trm84/SDP-BMS-CIRCUIT/12S.brd

## EAGLE design 12S.brd (2019-02-24)

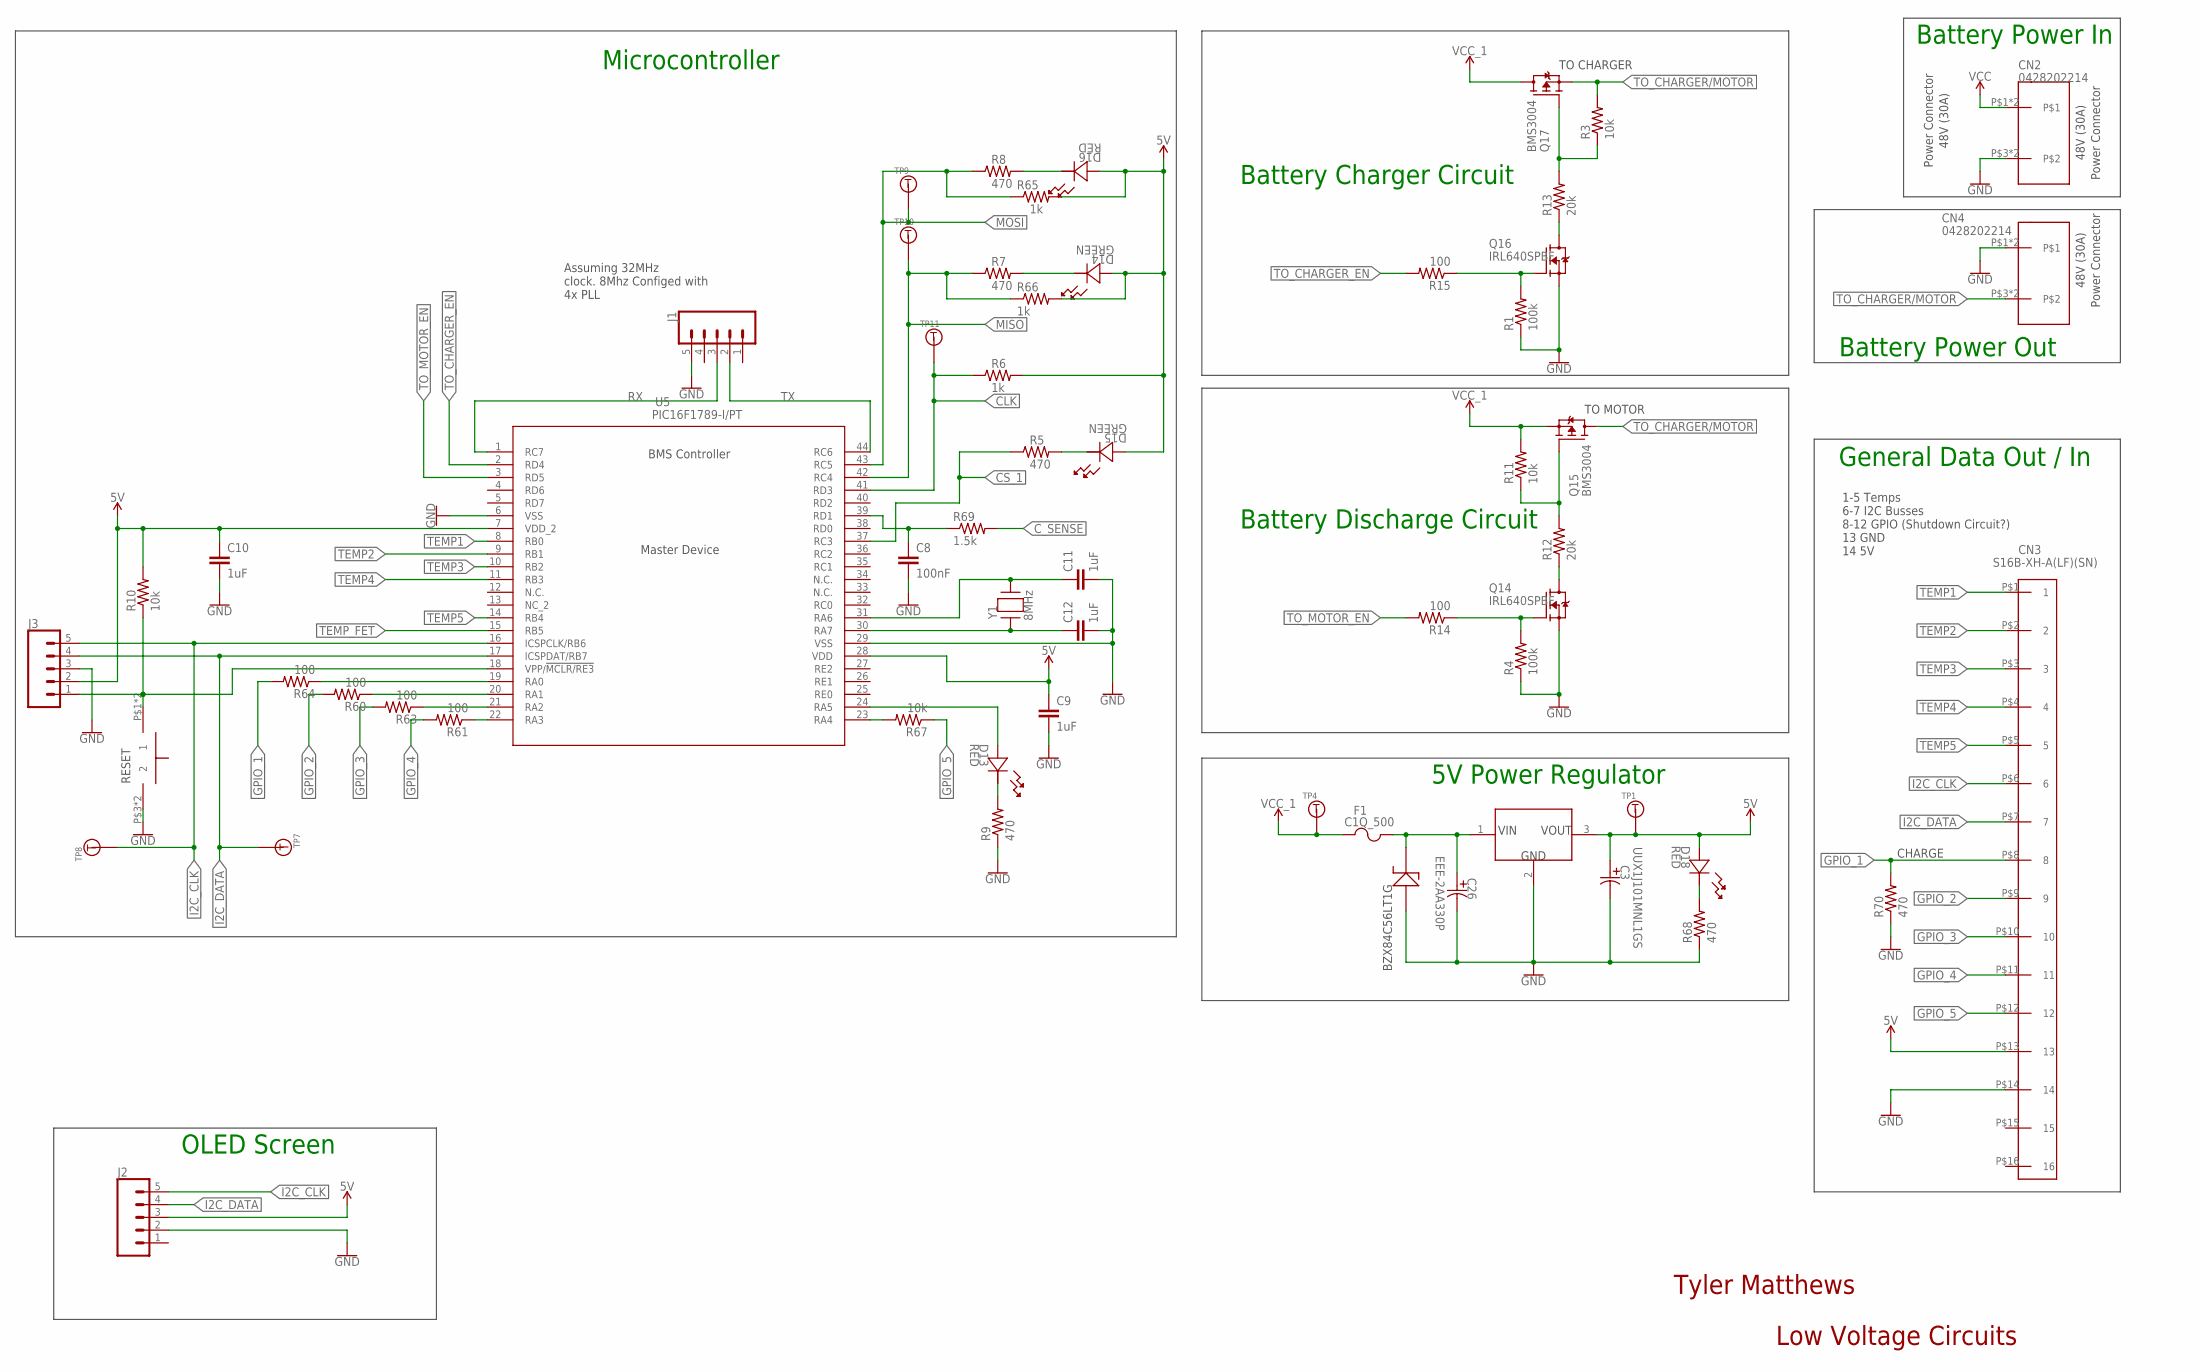
[picture p1: schematic 12S.sch, sheet 1]

Parts:
C3: UUX1J101MNL1GS; PCAP_10X10-ELECT
C8: 100nF; C0603
C9, C10, C11, C12: 1uF; C0603
C26: EEE-2AA330P; CAP_EEE_G
CN2, CN4: 0428202214
CN3: S16B-XH-A(LF)(SN)
D13, D16, D18: RED; LED_DIALIGHT_598
D14, D15: GREEN; LED_DIALIGHT_598
D17: BZX84C56LT1G; SOT-23
F1: C1Q_500; C1
J1, J2, J3: CONN_05; 1X05
Q14, Q16: IRL640SPBF; D2PAK
Q15, Q17: BMS3004; TO-220
R1, R4: 100k; R0603
R3, R10, R11, R67: 10k; R0603
R5, R7, R8, R9, R68, R70: 470; R0603
R6, R65, R66: 1k; R0603
R12, R13: 20k; R0603
R14, R15, R60, R61, R63, R64: 100; R0603
R69: 1.5k; R0603
S2: TL3305AF260QG
TP1, TP4, TP7, TP8, TP9, TP10, TP11: TP5015
U3: SRH05S05; SIP3
U5: PIC16F1789-I/PT; TQFP44_MC
Y1: 8MHz; CRYSTAL_HC49SDLF

Connections:
5V: C3.1 (11), C9.1, C10.1, CN3.P$13 (13), D14.2 (22), D15.2 (22), D16.2 (22), D18.2 (22), J2.3, J3.2, R6.2, R10.2, R65.2, R66.2, TP1.P$1, U3.3 (VOUT), U5.7 (VDD_2), U5.28 (VDD); also elsewhere on the board
CLK: R6.1, TP11.P$1, U5.41 (RD3); also elsewhere on the board
CS_1: R5.1, U5.37 (RC3); also elsewhere on the board
C_SENSE: R69.2; also elsewhere on the board
GND: C3.2 (22), C8.2, C9.2, C10.2, C11.2, C12.2, C26.2 (22), CN2.P$3, CN2.P$4, CN3.P$14 (14), CN4.P$1, CN4.P$2, D17.1, J1.5, J2.2, J3.3, Q14.2 (S), Q16.2 (S), R1.1, R4.1, R9.1, R68.1, R70.1, S2.P$3 (2), S2.P$4 (2), U3.2 (GND), U5.6 (VSS), U5.29 (VSS); also elsewhere on the board
GPIO_1: CN3.P$8 (8), R64.2, R70.2
GPIO_2: CN3.P$9 (9), R60.2
GPIO_3: CN3.P$10 (10), R63.2
GPIO_4: CN3.P$11 (11), R61.2
GPIO_5: CN3.P$12 (12), R67.1
I2C_CLK: CN3.P$6 (6), J2.5, J3.5, TP8.P$1, U5.16 (ICSPCLK/RB6)
I2C_DATA: CN3.P$7 (7), J2.4, J3.4, TP7.P$1, U5.17 (ICSPDAT/RB7)
MISO: R7.1, R66.1, TP10.P$1, U5.42 (RC4); also elsewhere on the board
MOSI: R8.1, R65.1, TP9.P$1, U5.43 (RC5); also elsewhere on the board
unnamed: D16.1 (11), R8.2
unnamed: D14.1 (11), R7.2
unnamed: D15.1 (11), R5.2
unnamed: Q17.1 (G), R3.1, R13.2
unnamed: R61.1, U5.22 (RA3)
unnamed: R63.1, U5.21 (RA2)
unnamed: R60.1, U5.20 (RA1)
unnamed: R64.1, U5.19 (RA0)
unnamed: D18.1 (11), R68.2
unnamed: R67.2, U5.23 (RA4)
unnamed: C8.1, R69.1, U5.39 (RD1)
unnamed: C26.1 (11), D17.3, F1.2, U3.1 (VIN)
unnamed: Q14.3 (D), R12.1
unnamed: C11.1, U5.31 (RA6), Y1.2
unnamed: C12.1, U5.30 (RA7), Y1.1
unnamed: Q15.1 (G), R11.1, R12.2
unnamed: Q14.1 (G), R4.2, R14.1
unnamed: Q16.3 (D), R13.1
unnamed: Q16.1 (G), R1.2, R15.1
unnamed: J3.1, R10.1, S2.P$1 (1), S2.P$2 (1), U5.18 (VPP/!MCLR/RE3)
unnamed: D13.2 (22), U5.24 (RA5)
unnamed: D13.1 (11), R9.2
RX: J1.3, U5.1 (RC7)
TEMP1: CN3.P$1 (1), U5.8 (RB0); also elsewhere on the board
TEMP2: CN3.P$2 (2), U5.9 (RB1); also elsewhere on the board
TEMP3: CN3.P$3 (3), U5.10 (RB2); also elsewhere on the board
TEMP4: CN3.P$4 (4), U5.11 (RB3); also elsewhere on the board
TEMP5: CN3.P$5 (5), U5.14 (RB4); also elsewhere on the board
TEMP_FET: U5.15 (RB5); also elsewhere on the board
TO_CHARGER/MOTOR: CN4.P$3, CN4.P$4, Q15.2 (D), Q17.3 (S), R3.2
TO_CHARGER_EN: R15.2, U5.2 (RD4)
TO_MOTOR_EN: R14.2, U5.3 (RD5)
TX: J1.2, U5.44 (RC6)
VCC: CN2.P$1, CN2.P$2; also elsewhere on the board
VCC_1: F1.1, Q15.3 (S), Q17.2 (D), R11.2, TP4.P$1; also elsewhere on the board

Notes on the sheet:
Master Device
BMS Controller
Assuming 32MHz clock. 8Mhz Configed with 4x PLL
Microcontroller
5V Power Regulator
Battery Discharge Circuit
Battery Charger Circuit
Power Connector
48V (30A)
Battery Power Out
General Data Out / In
1-5 Temps 6-7 I2C Busses 8-12 GPIO (Shutdown Circuit?) 13 GND 14 5V
Battery Power In
TO CHARGER
TO MOTOR
Tyler Matthews
Low Voltage Circuits
RESET
BZX84C56LT1G
CHARGE
OLED Screen

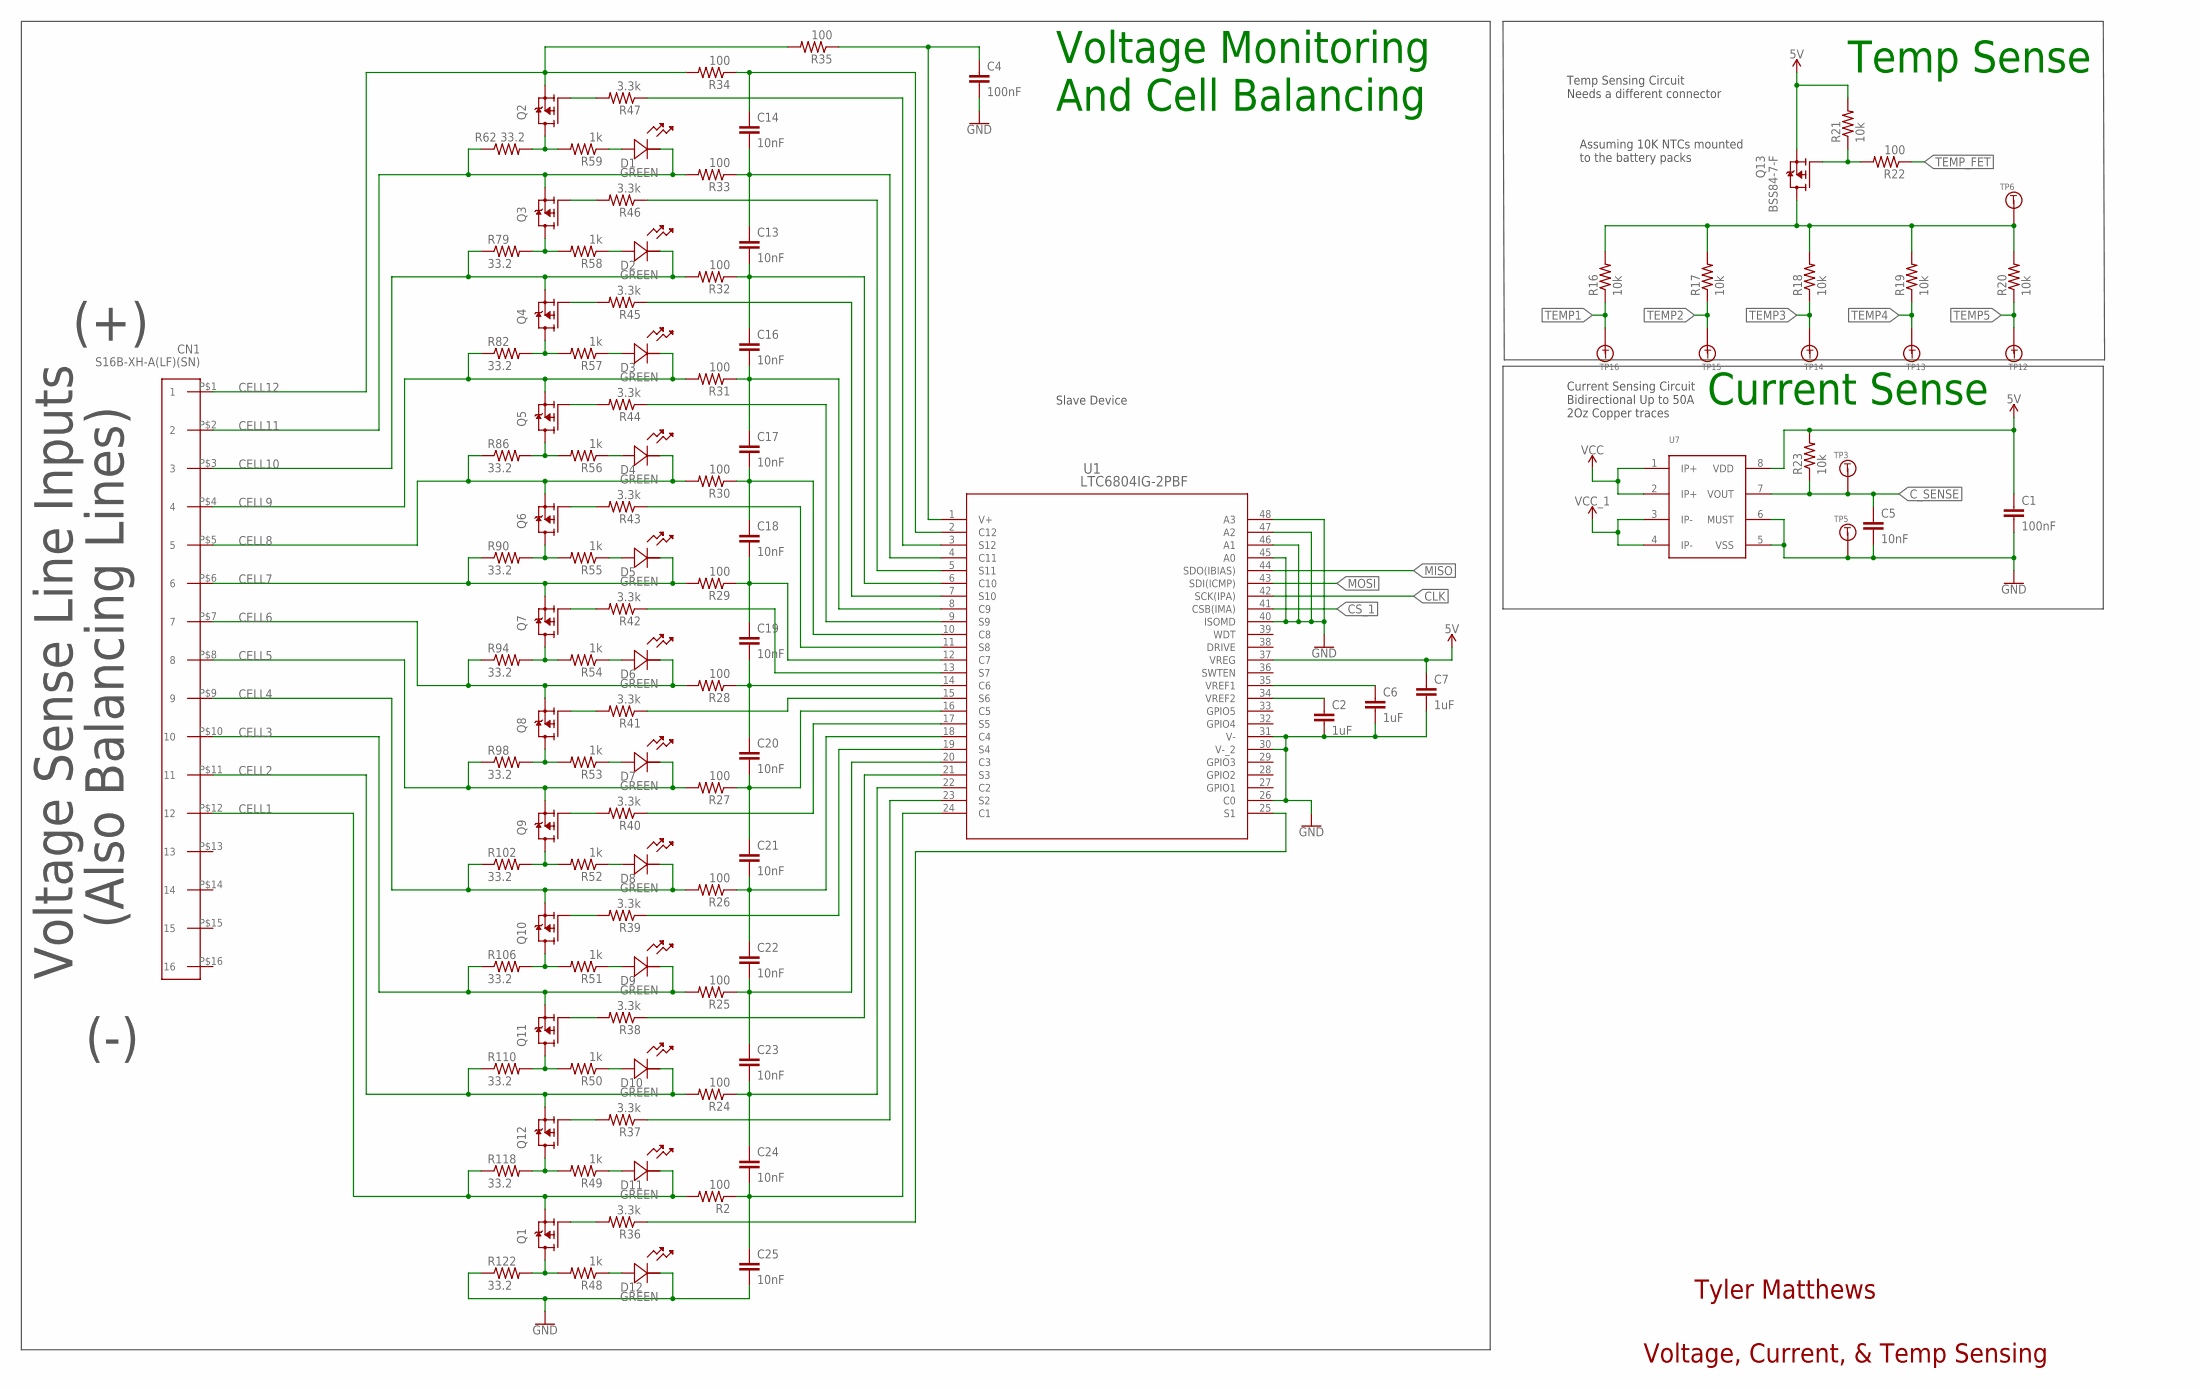
[picture p2: schematic 12S.sch, sheet 2]

Parts:
C1, C4: 100nF; C0603
C2, C6, C7: 1uF; C0603
C5, C13, C14, C16, C17, C18, C19, C20, C21, C22, C23, C24, C25: 10nF; C0603
CN1: S16B-XH-A(LF)(SN)
D1, D2, D3, D4, D5, D6, D7, D8, D9, D10, D11, D12: GREEN; LED_DIALIGHT_598
Q1, Q2, Q3, Q4, Q5, Q6, Q7, Q8, Q9, Q10, Q11, Q12: BSS308PEH6327XTSA1
Q13: BSS84-7-F; SOT-23
R2, R22, R24, R25, R26, R27, R28, R29, R30, R31, R32, R33, R34, R35: 100; R0603
R16, R17, R18, R19, R20, R21, R23: 10k; R0603
R36, R37, R38, R39, R40, R41, R42, R43, R44, R45, R46, R47: 3.3k; R0603
R48, R49, R50, R51, R52, R53, R54, R55, R56, R57, R58, R59: 1k; R0603
R62, R79, R82, R86, R90, R94, R98, R102, R106, R110, R118, R122: 33.2; R0805
TP3, TP5, TP6, TP12, TP13, TP14, TP15, TP16: TP5015
U1: LTC6804IG-2PBF; SSOP-48_G
U7: MLX91210; SOIC-8

Connections:
5V: C1.1, C7.1, Q13.2 (S), R21.2, R23.2, U1.37 (VREG), U7.8 (VDD); also elsewhere on the board
CELL1: CN1.P$12 (12), D11.1 (11), Q1.P$S (S), R2.2, R118.1
CELL2: CN1.P$11 (11), D10.1 (11), Q12.P$S (S), R24.2, R110.1
CELL3: CN1.P$10 (10), D9.1 (11), Q11.P$S (S), R25.2, R106.1
CELL4: CN1.P$9 (9), D8.1 (11), Q10.P$S (S), R26.2, R102.1
CELL5: CN1.P$8 (8), D7.1 (11), Q9.P$S (S), R27.2, R98.1
CELL6: CN1.P$7 (7), D6.1 (11), Q8.P$S (S), R28.2, R94.1
CELL7: CN1.P$6 (6), D5.1 (11), Q7.P$S (S), R29.2, R90.1
CELL8: CN1.P$5 (5), D4.1 (11), Q6.P$S (S), R30.2, R86.1
CELL9: CN1.P$4 (4), D3.1 (11), Q5.P$S (S), R31.2, R82.1
CELL10: CN1.P$3 (3), D2.1 (11), Q4.P$S (S), R32.2, R79.1
CELL11: CN1.P$2 (2), D1.1 (11), Q3.P$S (S), R33.2, R62.1
CELL12: CN1.P$1 (1), Q2.P$S (S), R34.2, R35.2
CLK: U1.42 (SCK(IPA)); also elsewhere on the board
CS_1: U1.41 (CSB(IMA)); also elsewhere on the board
C_SENSE: C5.1, R23.1, TP3.P$1, U7.7 (VOUT); also elsewhere on the board
GND: C1.2, C2.2, C4.2, C5.2, C6.2, C7.2, C25.2, D12.1 (11), R122.1, TP5.P$1, U1.26 (C0), U1.30 (V-_2), U1.31 (V-), U1.40 (ISOMD), U1.45 (A0), U1.46 (A1), U1.47 (A2), U1.48 (A3), U7.5 (VSS), U7.6 (MUST); also elsewhere on the board
MISO: U1.44 (SDO(IBIAS)); also elsewhere on the board
MOSI: U1.43 (SDI(ICMP)); also elsewhere on the board
unnamed: C6.1, U1.35 (VREF1)
unnamed: C2.1, U1.34 (VREF2)
unnamed: Q13.1 (G), R21.1, R22.2
unnamed: Q13.3 (D), R16.2, R17.2, R18.2, R19.2, R20.2, TP6.P$1
unnamed: Q2.P$G (G), R47.2
unnamed: R47.1, U1.3 (S12)
unnamed: C14.1, R34.1, U1.2 (C12)
unnamed: Q2.P$D (D), R59.2, R62.2
unnamed: D1.2 (22), R59.1
unnamed: C13.1, C14.2, R33.1, U1.4 (C11)
unnamed: R46.1, U1.5 (S11)
unnamed: Q3.P$G (G), R46.2
unnamed: Q3.P$D (D), R58.2, R79.2
unnamed: D2.2 (22), R58.1
unnamed: C13.2, C16.1, R32.1, U1.6 (C10)
unnamed: Q4.P$G (G), R45.2
unnamed: R45.1, U1.7 (S10)
unnamed: Q4.P$D (D), R57.2, R82.2
unnamed: D3.2 (22), R57.1
unnamed: Q5.P$G (G), R44.2
unnamed: C16.2, C17.1, R31.1, U1.8 (C9)
unnamed: R44.1, U1.9 (S9)
unnamed: Q5.P$D (D), R56.2, R86.2
unnamed: D4.2 (22), R56.1
unnamed: C17.2, C18.1, R30.1, U1.10 (C8)
unnamed: Q6.P$G (G), R43.2
unnamed: R43.1, U1.11 (S8)
unnamed: Q6.P$D (D), R55.2, R90.2
unnamed: D5.2 (22), R55.1
unnamed: C18.2, C19.1, R29.1, U1.12 (C7)
unnamed: Q7.P$G (G), R42.2
unnamed: Q7.P$D (D), R54.2, R94.2
unnamed: D6.2 (22), R54.1
unnamed: Q8.P$G (G), R41.2
unnamed: Q8.P$D (D), R53.2, R98.2
unnamed: D7.2 (22), R53.1
unnamed: Q9.P$G (G), R40.2
unnamed: Q9.P$D (D), R52.2, R102.2
unnamed: D8.2 (22), R52.1
unnamed: Q10.P$G (G), R39.2
unnamed: Q10.P$D (D), R51.2, R106.2
unnamed: D9.2 (22), R51.1
unnamed: Q11.P$G (G), R38.2
unnamed: Q11.P$D (D), R50.2, R110.2
unnamed: D10.2 (22), R50.1
unnamed: C23.2, C24.1, R24.1, U1.22 (C2)
unnamed: R38.1, U1.21 (S3)
unnamed: C22.2, C23.1, R25.1, U1.20 (C3)
unnamed: R39.1, U1.19 (S4)
unnamed: C21.2, C22.1, R26.1, U1.18 (C4)
unnamed: R40.1, U1.17 (S5)
unnamed: C20.2, C21.1, R27.1, U1.16 (C5)
unnamed: R41.1, U1.15 (S6)
unnamed: C19.2, C20.1, R28.1, U1.14 (C6)
unnamed: R42.1, U1.13 (S7)
unnamed: Q12.P$G (G), R37.2
unnamed: Q12.P$D (D), R49.2, R118.2
unnamed: D11.2 (22), R49.1
unnamed: R37.1, U1.23 (S2)
unnamed: C24.2, C25.1, R2.1, U1.24 (C1)
unnamed: Q1.P$G (G), R36.2
unnamed: Q1.P$D (D), R48.2, R122.2
unnamed: D12.2 (22), R48.1
unnamed: R36.1, U1.25 (S1)
TEMP1: R16.1, TP16.P$1; also elsewhere on the board
TEMP2: R17.1, TP15.P$1; also elsewhere on the board
TEMP3: R18.1, TP14.P$1; also elsewhere on the board
TEMP4: R19.1, TP13.P$1; also elsewhere on the board
TEMP5: R20.1, TP12.P$1; also elsewhere on the board
TEMP_FET: R22.1; also elsewhere on the board
V+: C4.1, R35.1, U1.1 (V+)
VCC: U7.1 (IP+), U7.2 (IP+); also elsewhere on the board
VCC_1: U7.3 (IP-), U7.4 (IP-); also elsewhere on the board

Notes on the sheet:
Slave Device
Voltage Monitoring And Cell Balancing
Voltage Sense Line Inputs
(Also Balancing Lines)
(+)
(-)
Temp Sensing Circuit Needs a different connector
Assuming 10K NTCs mounted to the battery packs
Temp Sense
Current Sensing Circuit Bidirectional Up to 50A 2Oz Copper traces
Current Sense
Tyler Matthews
Voltage, Current, & Temp Sensing

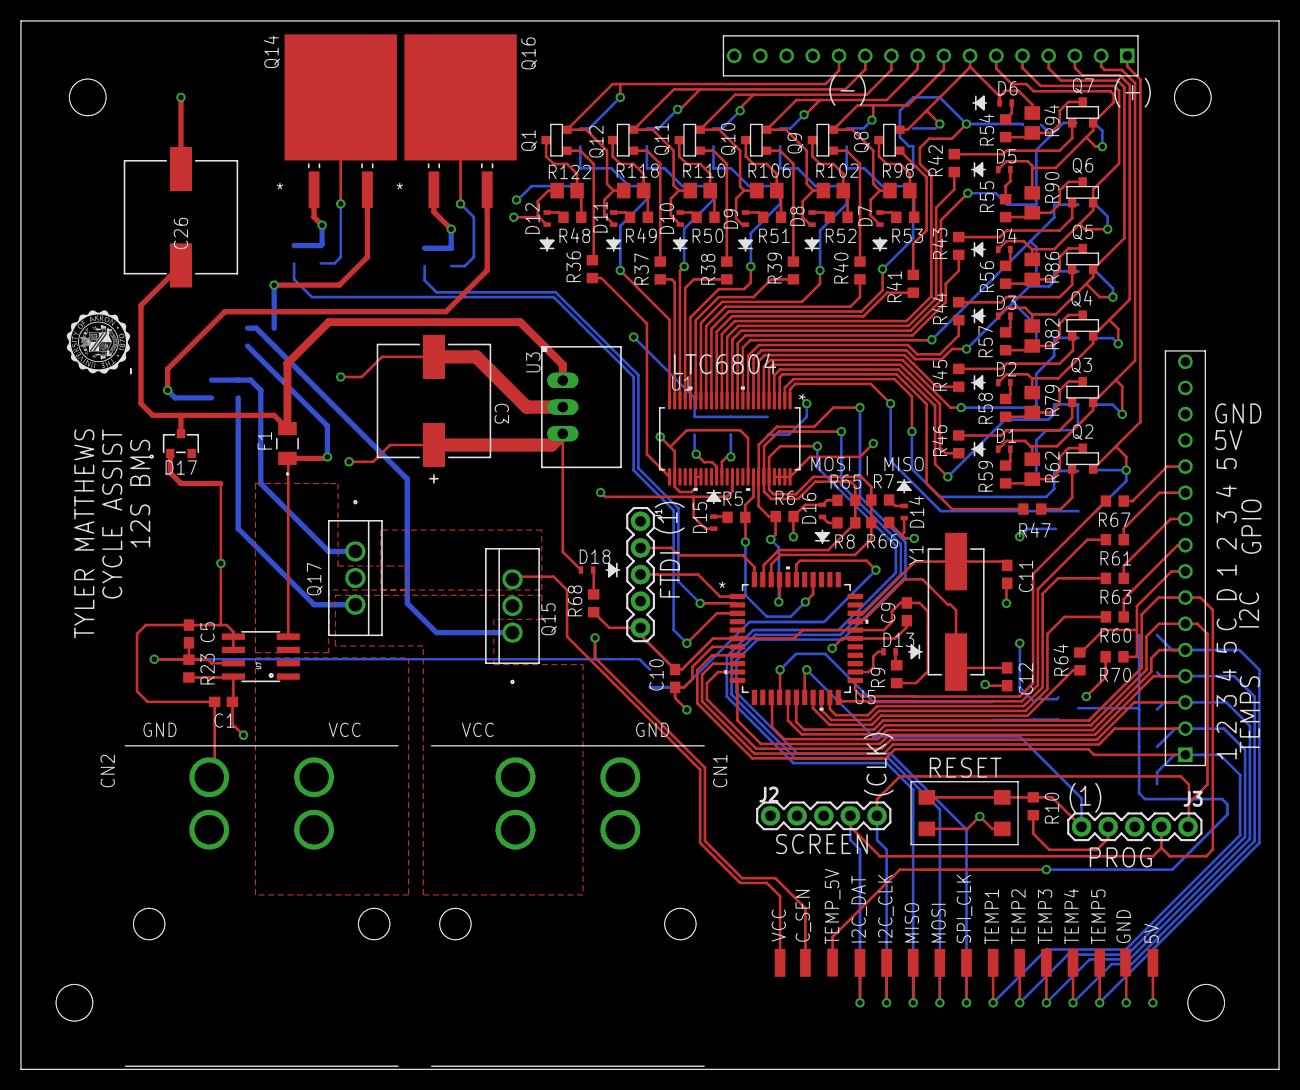
[picture p3: board 12S.brd from above]

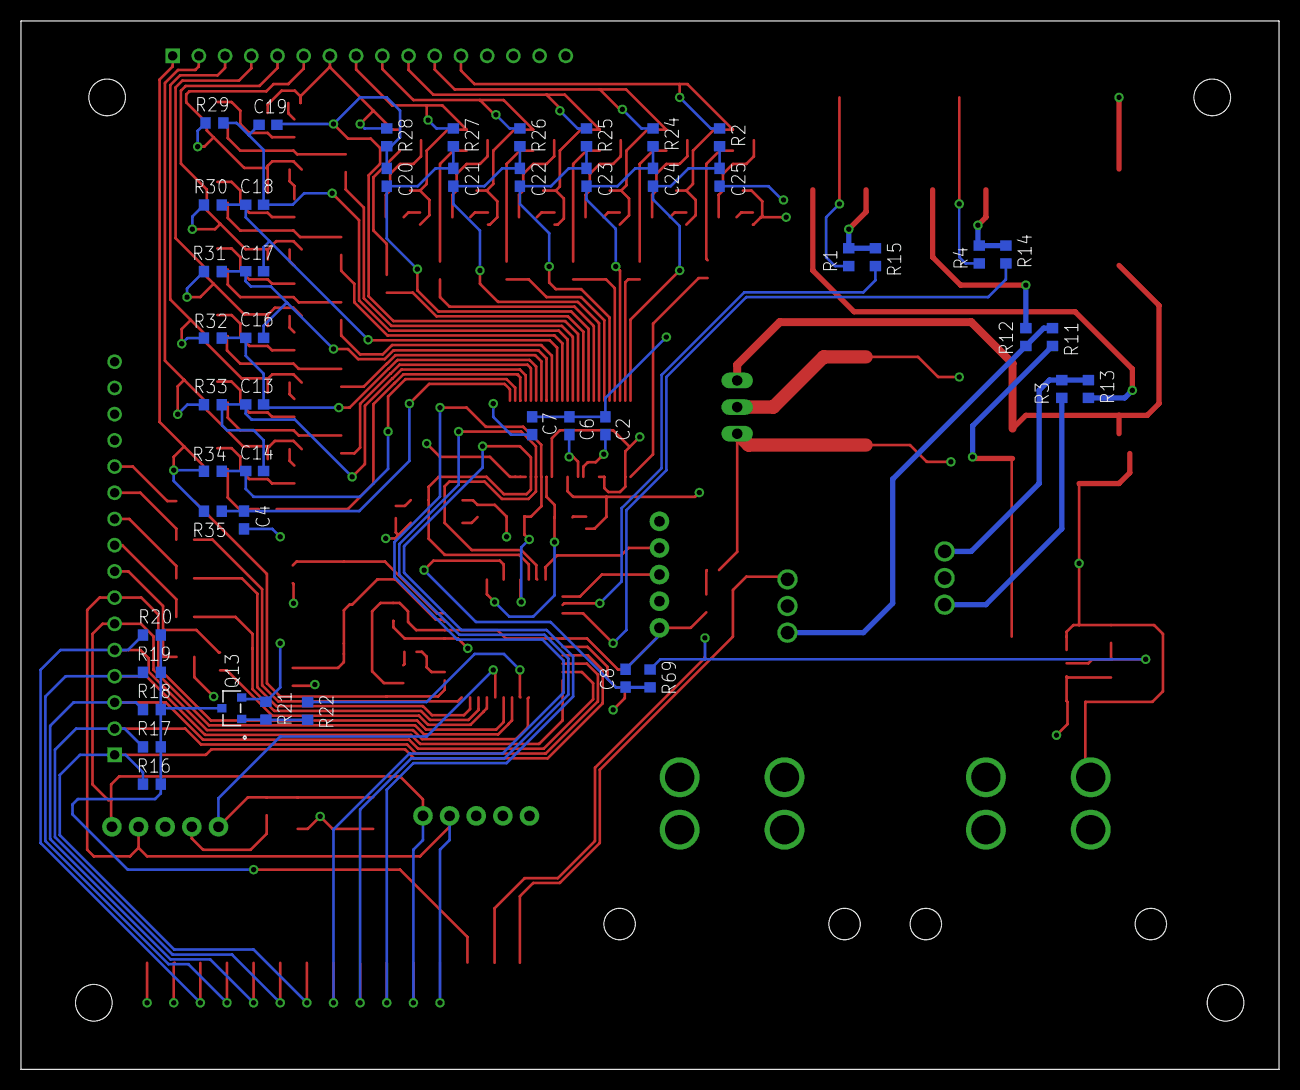
[picture p4: board 12S.brd from below]

Board: 4 copper layers, 120.0 x 100.0 mm, 170 parts (47 on the bottom side), 126 nets.
